DonohueRD/huey-console/hardware/huey_cart_v3/labels/labels_blank.pdf

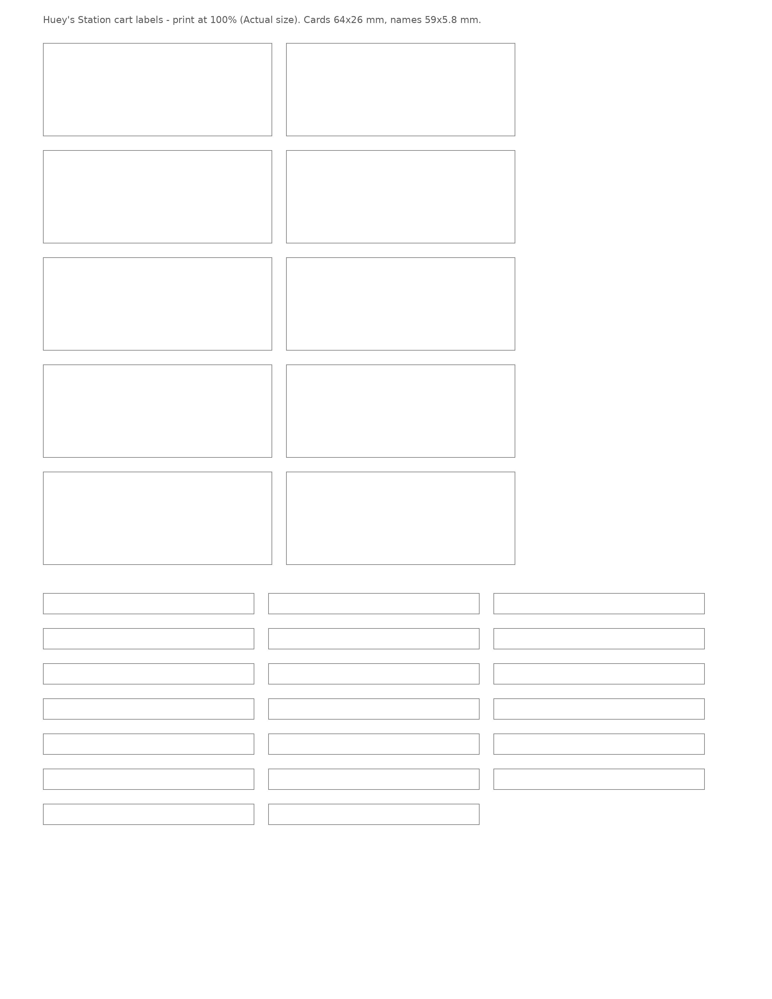
[picture p1: page 1]
