DonohueRD/huey-console/hardware/huey_cart_v3/labels/labels_sample.pdf

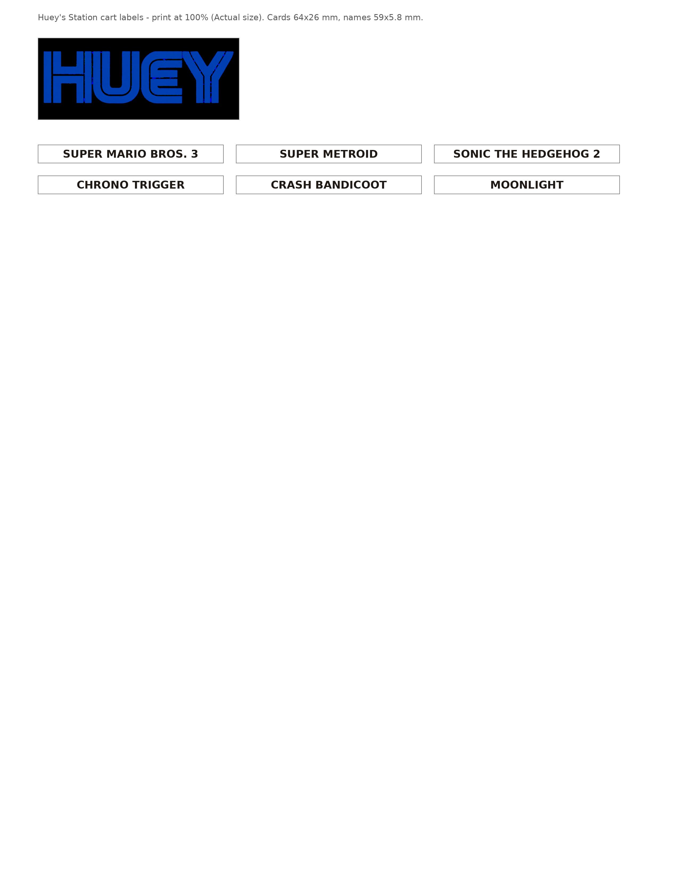
[picture p2: page 1]
