DonohueRD/huey-console/hardware/huey_cart_v3/cart_v3_slidein.png

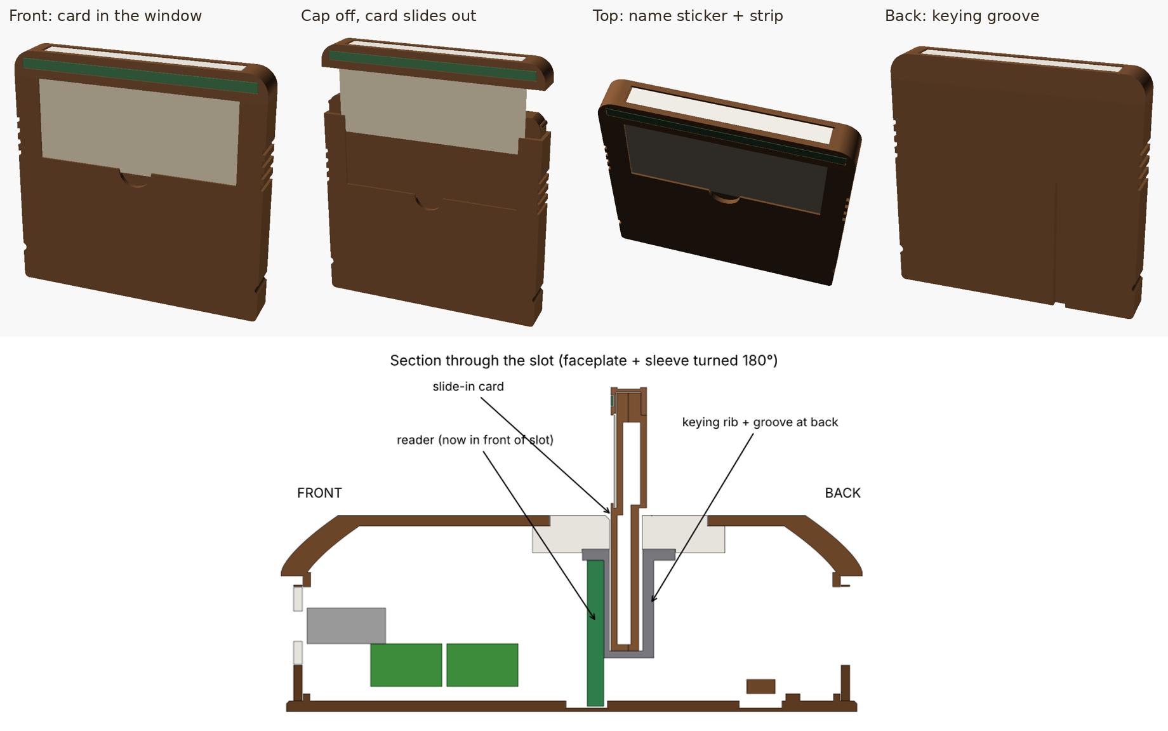
hardware/huey_cart_v3/cart_v3_slidein.png
