DonohueRD/huey-console/hardware/huey_cart_v3/labels/art/Huey's Station.png

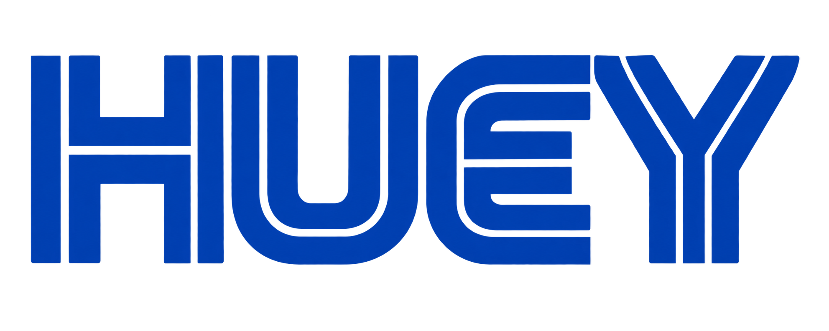
hardware/huey_cart_v3/labels/art/Huey's Station.png
