DonohueRD/huey-console/hardware/huey_station_v1/huey_station_renders.png

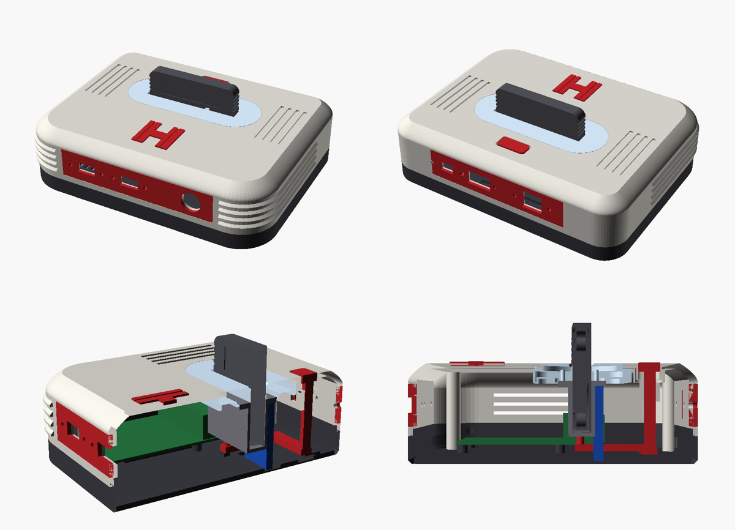
hardware/huey_station_v1/huey_station_renders.png
