DonohueRD/huey-console/hardware/huey_walnut_v1/walnut_edition_renders.png

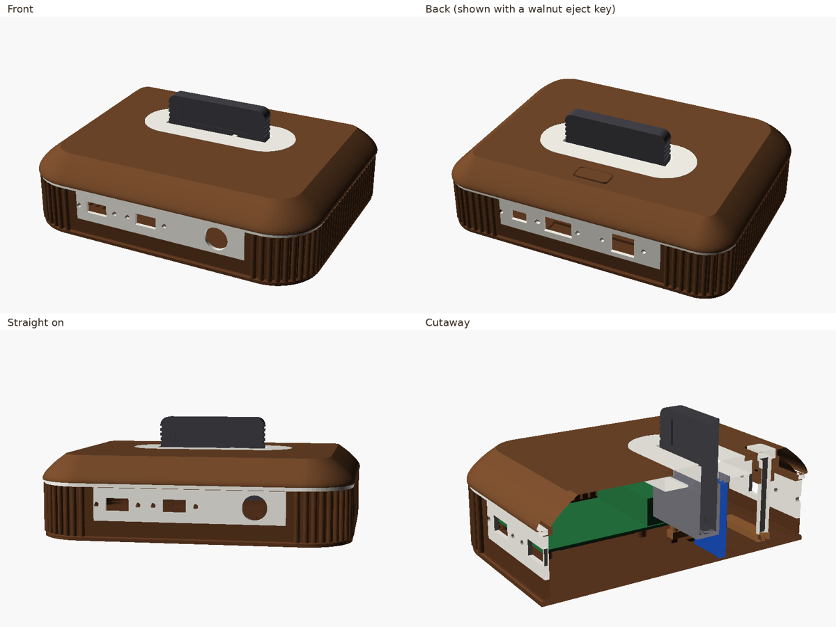
hardware/huey_walnut_v1/walnut_edition_renders.png
