DonohueRD/huey-console/hardware/huey_cart_v3/stl/cart_front.stl

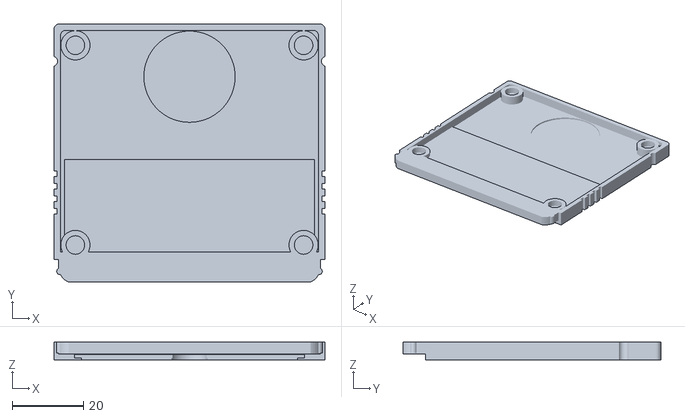
[picture p7: CAD file, 2026-10-06]
hardware/huey_cart_v3/stl/cart_front.stl
76.0 x 72.4 x 5.00
