DonohueRD/huey-console/hardware/huey_station_v1/stl/lever.stl

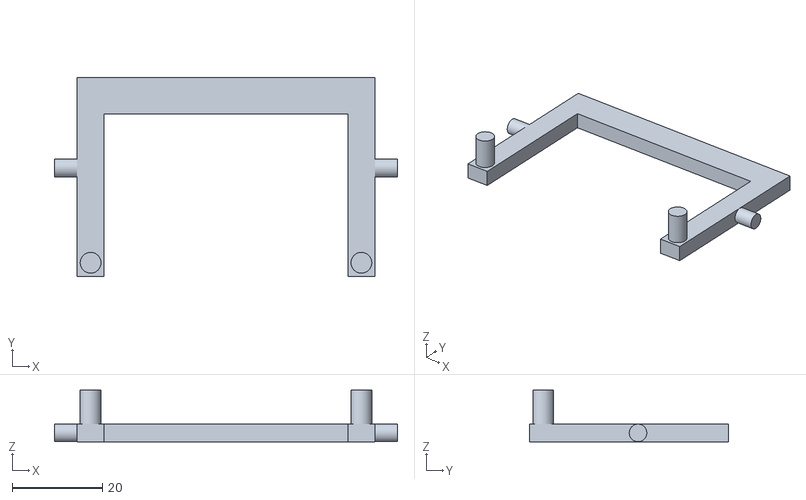
[picture p8: CAD file, 2026-10-06]
hardware/huey_station_v1/stl/lever.stl
76.0 x 44.0 x 11.5
