DonohueRD/huey-console/hardware/huey_cart_v3/stl/front_plate.stl

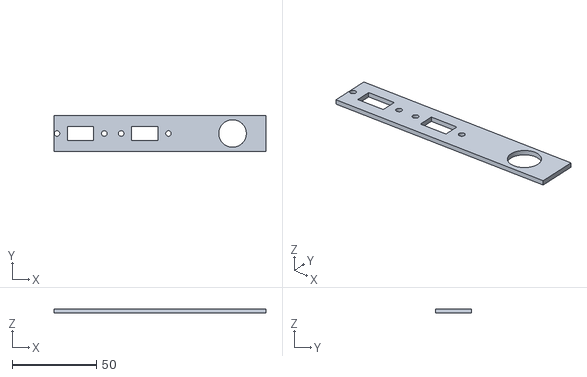
[picture p9: CAD file, 2026-10-06]
hardware/huey_cart_v3/stl/front_plate.stl
125.6 x 21.6 x 2.40
