DonohueRD/huey-console/hardware/huey_station_v1/stl/key.stl

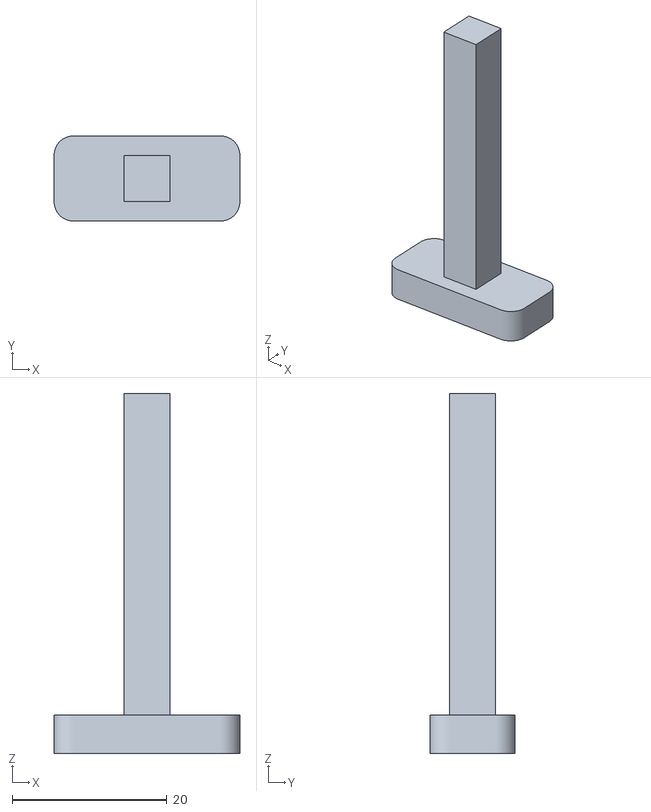
[picture p10: CAD file, 2026-10-06]
hardware/huey_station_v1/stl/key.stl
24.0 x 11.0 x 46.5
