DonohueRD/huey-console/hardware/huey_walnut_v1/stl/faceplate.stl

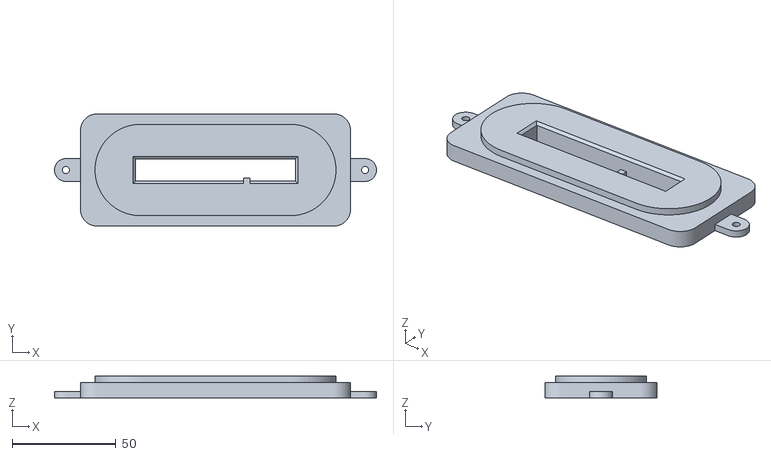
[picture p11: CAD file, 2026-10-06]
hardware/huey_walnut_v1/stl/faceplate.stl
155.0 x 54.0 x 10.5
