DonohueRD/huey-console/hardware/huey_cart_v3/stl/base.stl

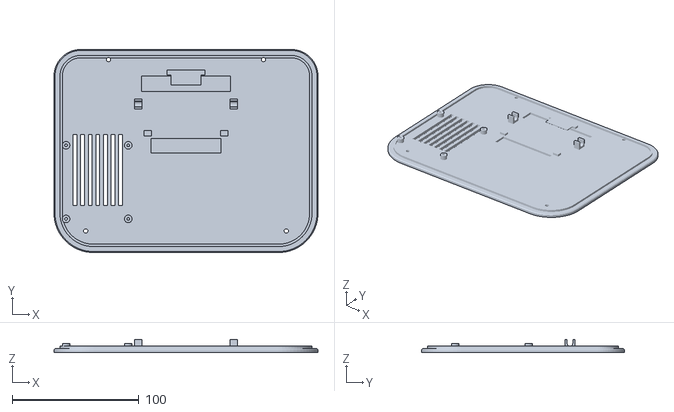
[picture p12: CAD file, 2026-10-06]
hardware/huey_cart_v3/stl/base.stl
208.0 x 160.0 x 10.0
