DonohueRD/huey-console/hardware/huey_station_v1/stl/front_insert.stl

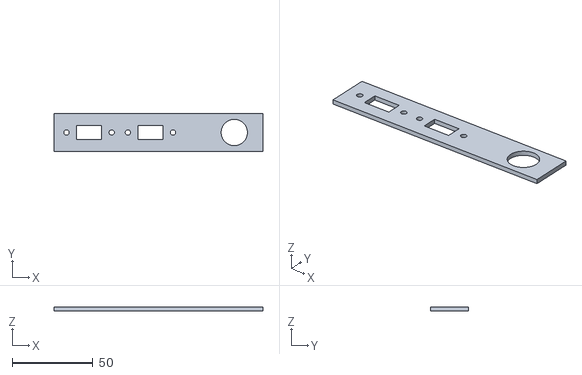
[picture p13: CAD file, 2026-10-06]
hardware/huey_station_v1/stl/front_insert.stl
129.6 x 23.6 x 2.40
