DonohueRD/huey-console/hardware/huey_cart_v3/stl/cart_cap.stl

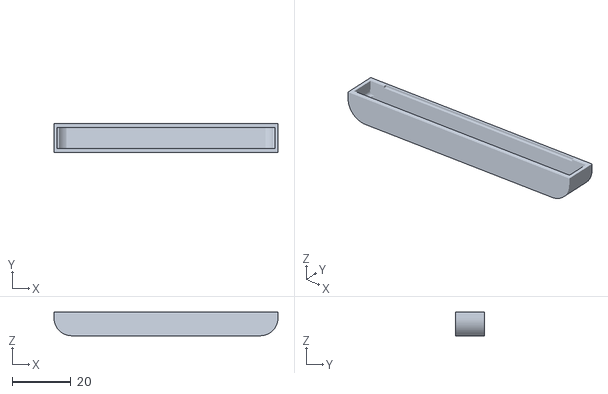
[picture p14: CAD file, 2026-10-06]
hardware/huey_cart_v3/stl/cart_cap.stl
76.0 x 10.0 x 8.00
