DonohueRD/huey-console/hardware/huey_station_v1/stl/cart_back.stl

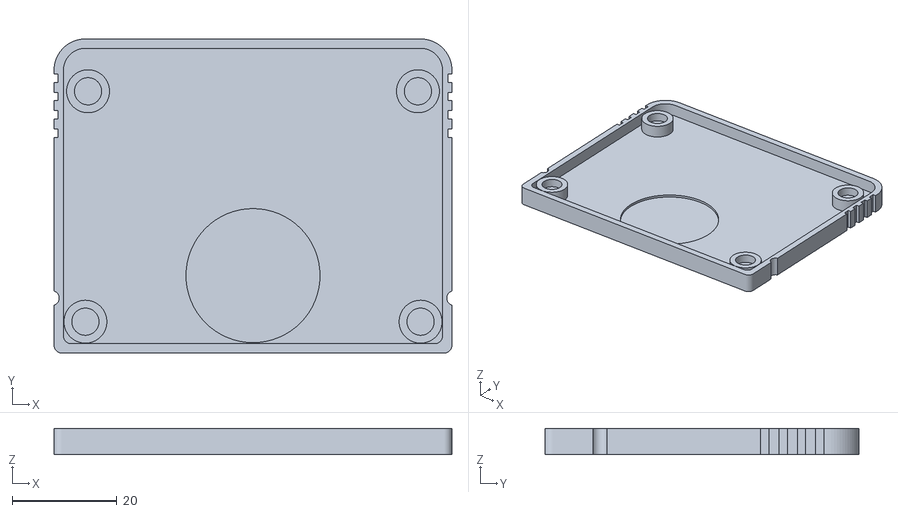
[picture p15: CAD file, 2026-10-06]
hardware/huey_station_v1/stl/cart_back.stl
76.0 x 60.0 x 5.00
