DonohueRD/huey-console/hardware/huey_walnut_v1/stl/body.stl

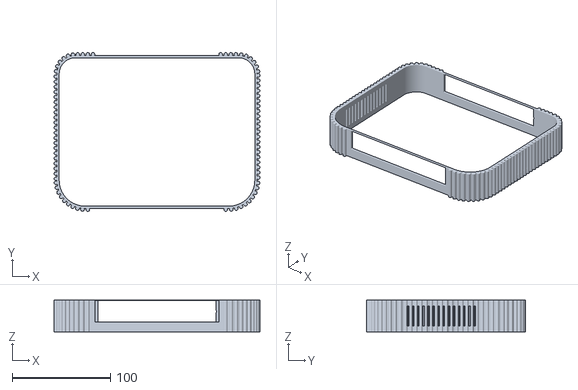
[picture p16: CAD file, 2026-10-06]
hardware/huey_walnut_v1/stl/body.stl
209.8 x 161.8 x 32.5
