DonohueRD/huey-console/hardware/huey_cart_v3/stl/body.stl

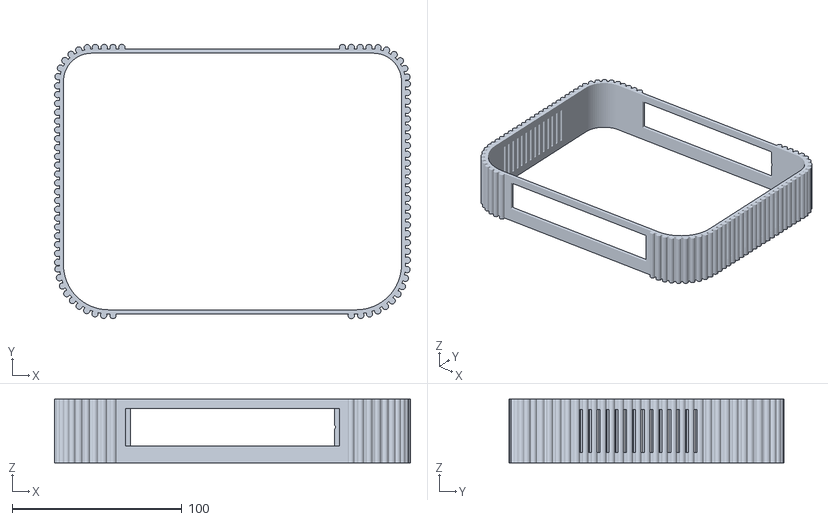
[picture p17: CAD file, 2026-10-06]
hardware/huey_cart_v3/stl/body.stl
209.8 x 161.8 x 37.5
