DonohueRD/huey-console/hardware/huey_walnut_v1/stl/sleeve.stl

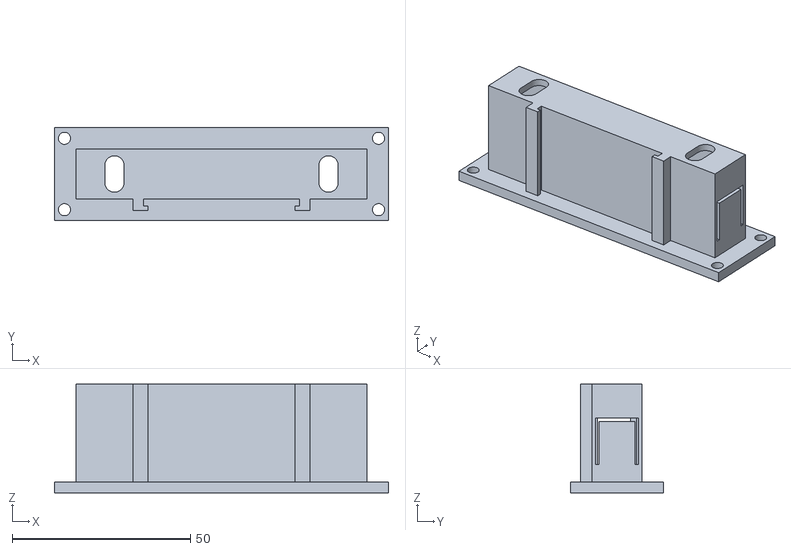
[picture p18: CAD file, 2026-10-06]
hardware/huey_walnut_v1/stl/sleeve.stl
93.6 x 26.0 x 30.5
