DonohueRD/huey-console/hardware/huey_cart_v3/stl/port_test.stl

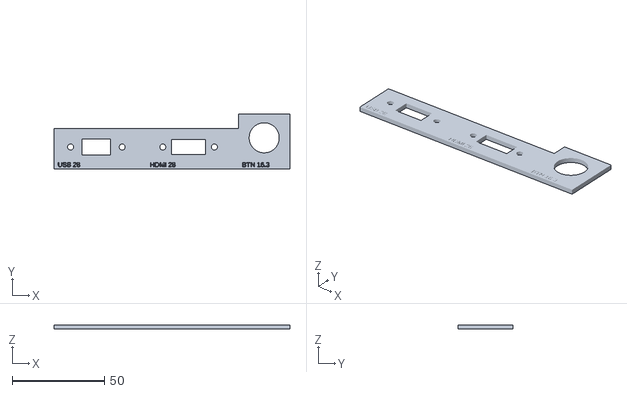
[picture p19: CAD file, 2026-10-06]
hardware/huey_cart_v3/stl/port_test.stl
128.0 x 30.0 x 2.40
