DonohueRD/huey-console/hardware/huey_station_v1/stl/base.stl

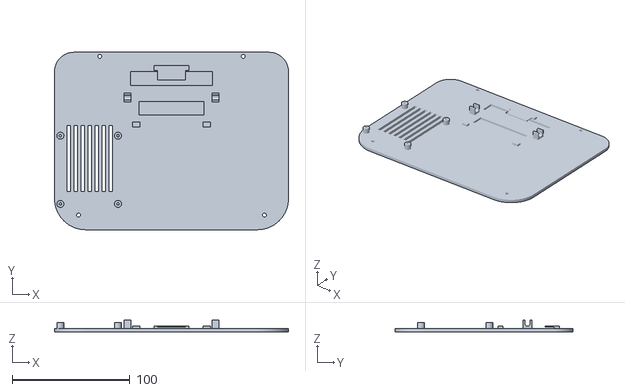
[picture p20: CAD file, 2026-10-06]
hardware/huey_station_v1/stl/base.stl
199.0 x 151.0 x 10.0
