DonohueRD/huey-console/hardware/huey_station_v1/stl/rear_insert.stl

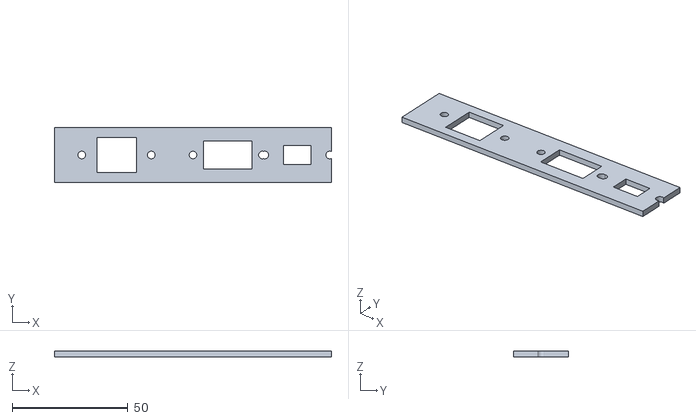
[picture p21: CAD file, 2026-10-06]
hardware/huey_station_v1/stl/rear_insert.stl
119.6 x 23.6 x 2.40
