DonohueRD/huey-console/hardware/huey_cart_v3/stl/cart_strip.stl

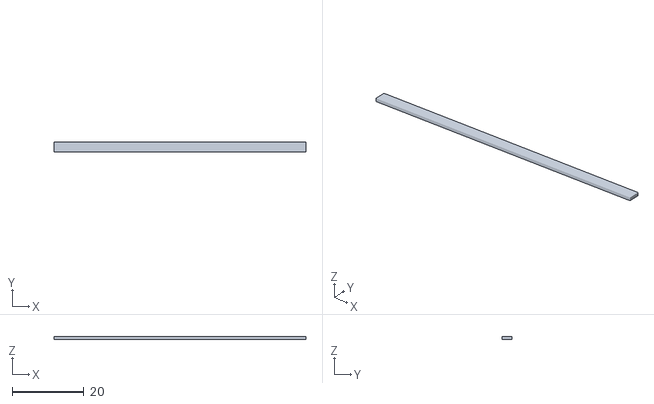
[picture p23: CAD file, 2026-10-06]
hardware/huey_cart_v3/stl/cart_strip.stl
70.0 x 2.80 x 0.8
