DonohueRD/huey-console/hardware/huey_cart_v3/stl/lever.stl

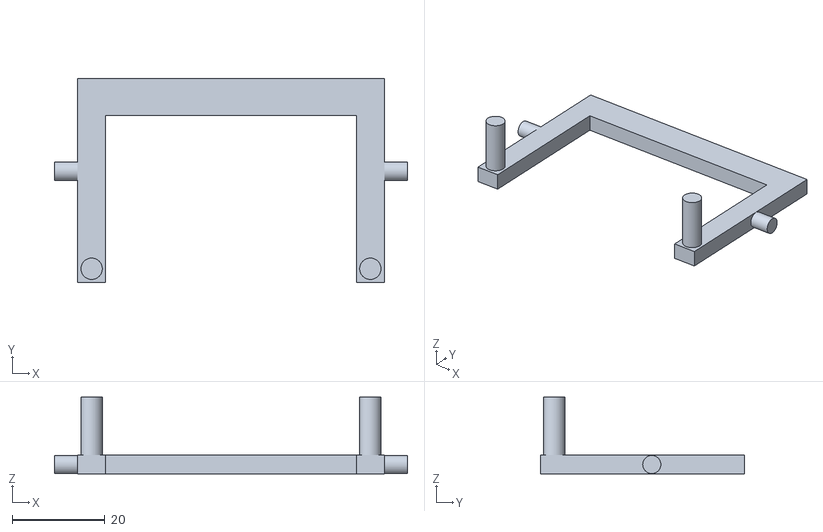
[picture p24: CAD file, 2026-10-06]
hardware/huey_cart_v3/stl/lever.stl
76.0 x 44.0 x 16.5
