DonohueRD/huey-console/hardware/huey_station_v1/stl/badge.stl

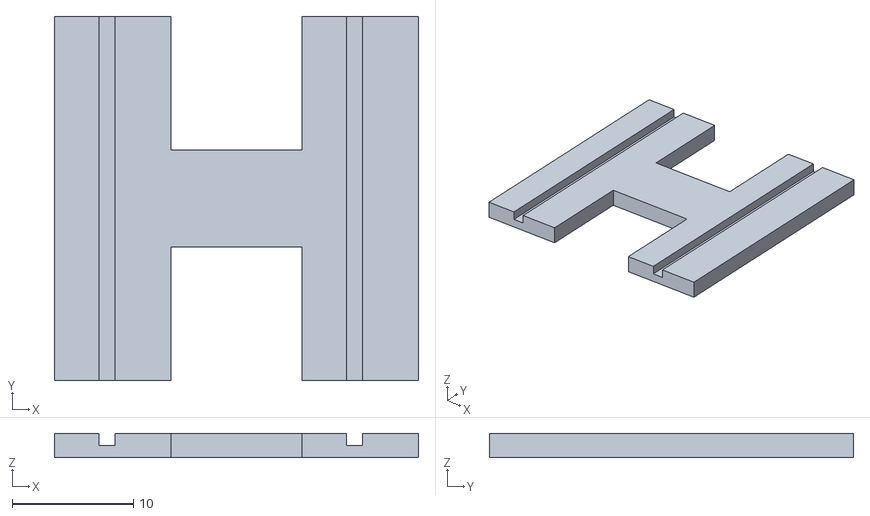
[picture p25: CAD file, 2026-10-06]
hardware/huey_station_v1/stl/badge.stl
30.0 x 30.0 x 2.00
