DonohueRD/huey-console/hardware/huey_walnut_v1/stl/cap.stl

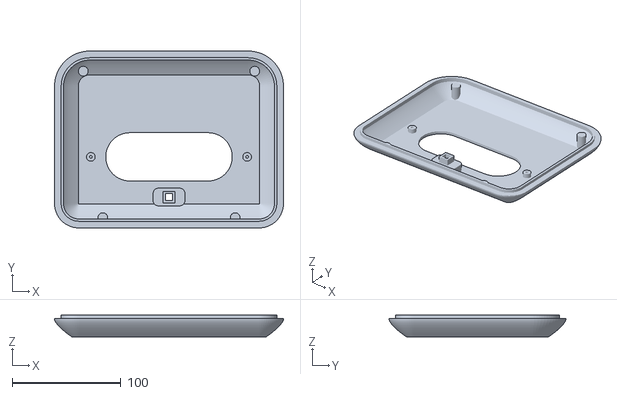
[picture p26: CAD file, 2026-10-06]
hardware/huey_walnut_v1/stl/cap.stl
211.0 x 163.0 x 20.0
