DonohueRD/huey-console/hardware/huey_cart_v3/stl/key.stl

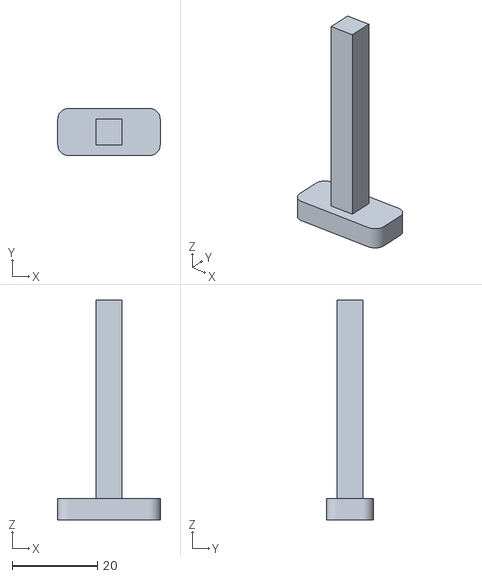
[picture p27: CAD file, 2026-10-06]
hardware/huey_cart_v3/stl/key.stl
24.0 x 11.0 x 51.5
