DonohueRD/huey-console/hardware/huey_station_v1/stl/shell.stl

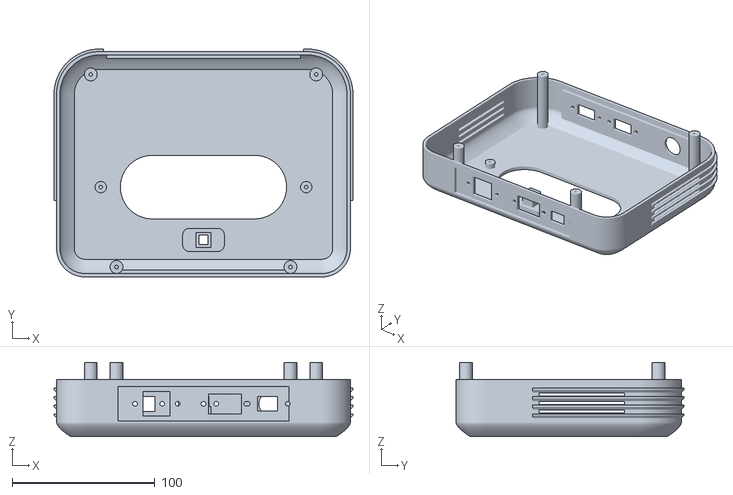
[picture p28: CAD file, 2026-10-06]
hardware/huey_station_v1/stl/shell.stl
209.6 x 159.8 x 52.0
