DonohueRD/huey-console/hardware/huey_walnut_v1/stl/ring.stl

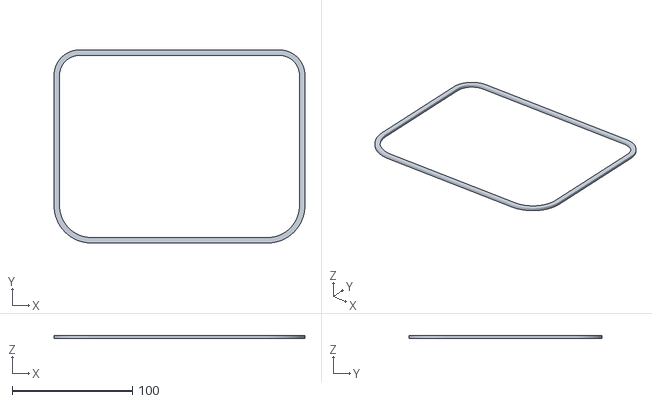
[picture p29: CAD file, 2026-10-06]
hardware/huey_walnut_v1/stl/ring.stl
208.4 x 160.4 x 2.50
