DonohueRD/huey-console/hardware/huey_cart_v3/stl/rear_plate.stl

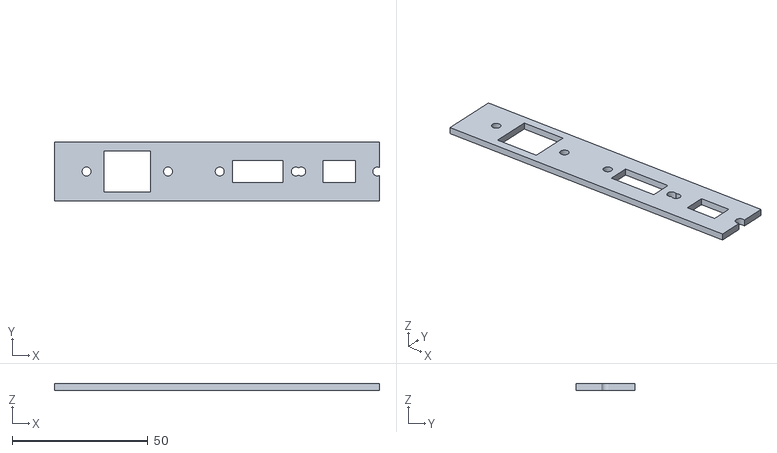
[picture p30: CAD file, 2026-10-06]
hardware/huey_cart_v3/stl/rear_plate.stl
119.6 x 21.6 x 2.40
