DonohueRD/huey-console/hardware/huey_station_v1/stl/bezel.stl

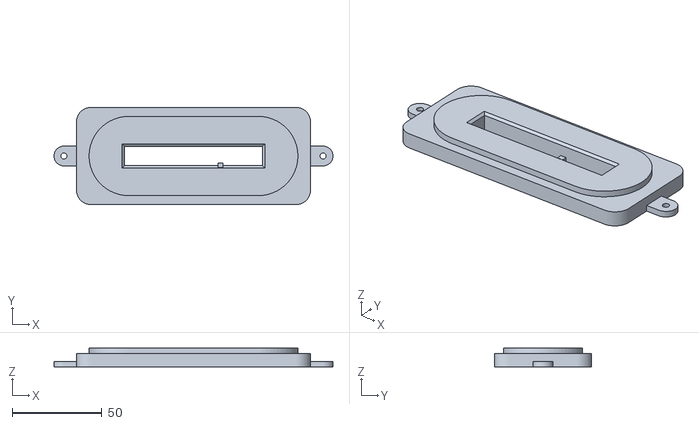
[picture p31: CAD file, 2026-10-06]
hardware/huey_station_v1/stl/bezel.stl
155.0 x 54.0 x 10.5
