DonohueRD/huey-console/hardware/huey_station_v1/stl/band.stl

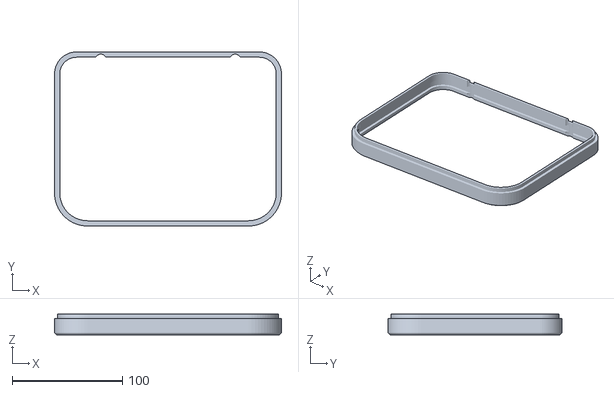
[picture p32: CAD file, 2026-10-06]
hardware/huey_station_v1/stl/band.stl
206.0 x 158.0 x 19.0
