DonohueRD/huey-console/hardware/huey_cart_v3/huey_walnut.scad

// =====================================================================
//  HUEY'S STATION — WALNUT EDITION
//  Reeded walnut body, crowned walnut top, thin marble line around the top,
//  inlaid marble front + rear plates, solid marble slot faceplate,
//  SNES-style eject key (print in wood or marble).
//
//  Uses the existing carts and reader. The sleeve is reprinted (v2) only
//  to add the eject plunger holes; the cart cavity, keying rib and click
//  detent are identical to the original.
//
//  Set `part`, F6, export STL. Parts are oriented for printing.
//  Bambu P1S, all dimensions in mm.
// =====================================================================

/* [Part] */
// assembly | cap | body | ring | base | faceplate | sleeve | lever | key | front_plate | rear_plate
// cart_front | cart_back | cart_cap | cart_strip | label_card | port_test
part = "assembly";
eject_pressed = false;   // assembly preview: show the eject travel
slot_flip = true;        // faceplate + sleeve installed turned 180°: keying rib at the BACK, reader at the front
explode_cap = 0;         // assembly preview: lift the cart cap

/* [Body] */
W = 206;  D = 158;  H = 60;   // 2026-10-05: was 55; +5 mm so the reader PCB clears the base (only body, lever, key change)
front_r = 30;  back_r = 20;   // same footprint as the v1 detailed model
crown = 16;  crown_p = 1.45;  // crowned top: 16 mm rise, max ~55° so it prints upside down
wall = 2.4;  top_t = 3;  base_t = 3;
core = 1.0;                   // body core sits 1 mm inside the footprint; reeds stand proud
reed_r = 1.9;  reed_pitch = 5.2;
ring_t = 2.5;                 // thin marble line between body and top
zr = H - crown - 1 - ring_t;  // top of the reeded body (35.5)
zc = zr + ring_t;             // bottom of the walnut top (38)
cap_over = 2.5;               // top overhangs the reeds slightly, like the stand's top lip
lip = 3;                      // top's lip that drops inside the body
inner_in = core + wall;       // inner wall inset (3.4)

/* [Slot / bezel] */
slot_x = W/2;  slot_y = 95;
pill = [116, 44];       // visible clear bezel
flange = [130, 54];     // bezel flange under the top skin
bezel_t = 10.5;         // same stack height as the original disc
ear_x = 72;             // bezel screw ears (each side)
led_in  = [98, 30];     // LED channel inner edge (clears the sleeve flange)
led_out = [124, 50];    // LED channel outer edge (10 mm strip)
led_d   = 3;

/* [Eject] */
eject_y  = 132;         // key position (behind the slot)
pivot_y  = 116;          // closer to the key = more lift at the cart
plunger_x = 30;         // plungers at ±30 mm under the cart
arm_w = 6;  arm_t = 4;  arm_z = 5;      // lever arms: z 5..9 at rest
key_cap = [24, 11];  key_stem = 6;  key_travel = 3.5;   // cart lifts ~4.6 mm

/* [Raspberry Pi 3: long axis front-to-back, USB end at the back] */
pi_x0 = 5;  pi_y0 = 22;  standoff = 4;

/* [Front panel parts — measure yours and adjust] */
// 2026-10-04 measured: USB-A flange ~39.5 x 11.4, nose ~15 x 7. port_test printed: USB + HDMI cutouts and screw spacing fit
usb_face  = [15.5, 8.5];  usb_body = [18, 10.5];  usb_screw = 28;   // USB-A panel mount
usb_x = [56, 94];       // centres
// 2026-10-04 measured: 16 mm thread, head ~19.5, depth incl. pins ~24.5
btn_d = 16.3;  btn_x = 146;
/* [Rear panel parts — measure yours and adjust] */
// RJ45 and power panel mounts not bought yet: standard dimensions
rj_face = [17, 15];   rj_screw = 30;  rj_x = 70;     // RJ45 panel mount
// 2026-10-04 measured: flange 38.4 x 11.1, nose 17.7 x 7.1, holes 31 outside-to-outside (M3 brass) = 28 centres
hdmi_face = [18.6, 8]; hdmi_screw = 28; hdmi_x = 118; // HDMI panel mount
pwr_face = [12, 8];   pwr_screw = 28; pwr_x = 148;   // micro-USB / USB-C panel mount
screw_d = 3.3;

/* [Cart, reader, sleeve — unchanged from the original design] */
cart_w = 76;  cart_t = 10;  cart_h = 74;  insert_depth = 38;   // v3 cart: 36 mm stands above the slot
cart_wall = 1.8;  clear = 0.4;  key_x = 15;  rib_w = 3;  rib_d = 1.6;
tongue_len = 12;  tongue_w = 10;  tongue_top = 8;  bump = 0.8;  bump_r = 1.2;
pcb_w = 43;  pcb_h = 41;  pcb_t = 1.6;  rail_lip = 1.2;
tag_d = 25;  mag_d = 5.2;  mag_h = 2.2;
/* [Cart v3: slide-in card + clip cap] */
cap_h = 8;  ten = 1.6;  ten_end = 1.2;  cap_fit = 0.15;   // cap slips over a tenon
card = [64, 26];  card_t = 0.9;                // card channel (cardstock / photo paper, ~0.3 mm)
win_x = 60.6;  lip_t = 0.6;  card_z0 = insert_depth + 2;  // window: lips 1.7 mm each side
strip = [cart_w - 6, 2.8, 0.8];                // system-color strip on the cap front
name_rec = [60, 6.4, 0.6];                     // name sticker recess on the cap top

$fn = 64;  eps = 0.01;

// ------------------------------------------------------------- derived --
ow = cart_w + 2*clear;  ot = cart_t + 2*clear;
end_w = 2.4;  side_w = 1.6;
sf_pad = 6;  sf_t = 3;  sf_pocket = 1;
sleeve_in = insert_depth - (bezel_t - sf_pocket);     // 28.5
sleeve_floor = 2;
sx = ow/2 + end_w;  sy = ot/2 + side_w;
sf_x = sx + sf_pad;  sf_y = sy + sf_pad;
sf_holes = [[ sf_x-2.8,  sy+3], [-(sf_x-2.8),  sy+3],
            [ sf_x-2.8, -(sy+3)], [-(sf_x-2.8), -(sy+3)]];
bezel_z0 = H - bezel_t;                       // bezel underside (world)
sleeve_top = bezel_z0 + sf_pocket;            // sleeve flange top (world)
cart_bottom = H - insert_depth;               // 17
floor_bot = cart_bottom - sleeve_floor;       // 15
reader_mid = sleeve_top - sf_t - pcb_h/2;
tag_z = max(reader_mid - cart_bottom, cart_wall + tag_d/2 + 0.5);
det_from_top = tongue_top + tongue_len - 2;
det_z = insert_depth - (bezel_t - sf_pocket) - det_from_top;
pivot_z = arm_z + arm_t/2;
lift_ratio = (pivot_y - slot_y) / (eject_y - pivot_y);
base_bosses = [[24, 16], [W-24, 16], [42, 151], [W-42, 151]];
fp = [W/2 - 63, 13, 126, 22];   // inlaid marble front plate x, z, w, h
rp = [W/2 - 60, 13, 120, 22];   // inlaid marble rear plate

// ================================================================ body ==
module foot2d(g = 0) offset(delta = g) hull() {
    for (x = [front_r, W - front_r]) translate([x, front_r]) circle(front_r);
    for (x = [back_r, W - back_r]) translate([x, D - back_r]) circle(back_r);
}
module zslab(z0, z1) translate([-50, -50, z0]) cube([W + 100, D + 100, z1 - z0]);
function crown_pts(off, ztop) = [for (i = [0:14]) let(d = crown*i/14) [crown*pow(1 - d/crown, crown_p) - off, ztop - d]];
module slices(pts) hull() for (q = pts) translate([0, 0, q[1]]) linear_extrude(eps) foot2d(-q[0]);
module cap_outer() slices(concat([[-cap_over, zc]], crown_pts(cap_over, H)));
module cap_inner() slices(concat([[inner_in, zc - 1]], crown_pts(-inner_in, H - top_t)));
module pill2d(sz, grow = 0) offset(r = sz[1]/2 + grow) square([sz[0] - sz[1], eps], center = true);
module rrect2d(sz, r) offset(r = r) square([sz[0] - 2*r, sz[1] - 2*r], center = true);
function pi_holes() = [for (hx = [3.5, 52.5], hy = [3.5, 61.5]) [pi_x0 + hx, pi_y0 + hy]];

// reed centres around the footprint, tagged by face
function arc(cx, cy, r, a0, step) = let(da = step / r * 180 / PI)
    [for (a = [a0 + da/2 : da : a0 + 90 - da/4]) [cx + r*cos(a), cy + r*sin(a), "c"]];
function reeds_pts() = let(s = reed_pitch, fr = front_r, br = back_r) concat(
    [for (x = [fr + s/2 : s : W - fr]) [x, 0, "front"]], arc(W - fr, fr, fr, -90, s),
    [for (y = [fr + s/2 : s : D - br]) [W, y, "right"]],  arc(W - br, D - br, br, 0, s),
    [for (x = [W - br - s/2 : -s : br]) [x, D, "back"]],  arc(br, D - br, br, 90, s),
    [for (y = [D - br - s/2 : -s : fr]) [0, y, "left"]],  arc(fr, fr, fr, 180, s));
function reed_ok(p) = !(p[2] == "front" && abs(p[0] - (fp[0] + fp[2]/2)) < fp[2]/2 + 3)
                   && !(p[2] == "back"  && abs(p[0] - (rp[0] + rp[2]/2)) < rp[2]/2 + 3);
// vent slots hide in the valleys between reeds on the left (over the Pi) and right
function vent_ys() = [for (y = [front_r + reed_pitch : reed_pitch : D - back_r]) if (y > 40 && y < 112) y];

// ========================================================== walnut top ===
// Crowned top, z = zc..H. Prints upside down on its flat plateau.
module cap() {
    difference() {
        union() {
            difference() { cap_outer(); cap_inner(); }
            // lip that drops inside the marble ring and the body
            translate([0, 0, zc - lip]) linear_extrude(lip + 1)
                difference() { foot2d(-inner_in - 0.25); foot2d(-inner_in - 2.4); }
            intersection() {
                cap_outer();
                union() {
                    for (p = base_bosses) translate([p[0], p[1], base_t]) cylinder(d = 9, h = H);
                    for (m = [-1, 1]) translate([slot_x + m*ear_x, slot_y, bezel_z0 + 3]) cylinder(d = 8, h = 10);
                    translate([slot_x, eject_y, H - 9 - 1.6]) linear_extrude(9 + 1.6)
                        rrect2d([key_cap[0] + 2 + 3.2, key_cap[1] + 2 + 3.2], 4.6);
                    translate([slot_x, eject_y, H - 21]) linear_extrude(12) square(key_stem + 4.6, center = true);
                }
            }
        }
        for (p = base_bosses) translate([p[0], p[1], -1]) cylinder(d = 2.6, h = base_t + 14);
        for (m = [-1, 1]) translate([slot_x + m*ear_x, slot_y, bezel_z0]) cylinder(d = 2.6, h = 9);
        translate([slot_x, slot_y, H - top_t - 1]) linear_extrude(top_t + 2) pill2d(pill, 0.25);
        translate([slot_x, eject_y, H - 9]) linear_extrude(10) rrect2d([key_cap[0] + 2, key_cap[1] + 2], 3);
        translate([slot_x, eject_y, H - 30]) linear_extrude(30) square(key_stem + 0.6, center = true);
    }
}

// ========================================================== marble ring ===
module ring() translate([0, 0, zr]) linear_extrude(ring_t)
    difference() { foot2d(1.2); foot2d(-inner_in); }

// ======================================================= reeded body ===
// Walnut walls z = base_t..zr. Prints right side up (an open tube, no overhangs).
module body() {
    difference() {
        union() {
            translate([0, 0, base_t]) linear_extrude(zr - base_t) foot2d(-core);
            for (p = reeds_pts()) if (reed_ok(p)) translate([p[0], p[1], base_t]) cylinder(r = reed_r, h = zr - base_t, $fn = 16);
            // backing pads behind the inlaid plates
            intersection() {
                translate([0, 0, base_t]) linear_extrude(zr) foot2d(-core);
                union() {
                    translate([fp[0] - 3, inner_in - eps, fp[1] - 3]) cube([fp[2] + 6, 2.4, zr - lip - 0.5 - fp[1] + 3]);
                    translate([rp[0] - 3, D - inner_in - 2.4 + eps, rp[1] - 3]) cube([rp[2] + 6, 2.4, zr - lip - 0.5 - rp[1] + 3]);
                }
            }
        }
        translate([0, 0, base_t - 1]) linear_extrude(zr + 2) foot2d(-inner_in);
        // inlay recesses (flush marble plates) + openings
        translate([fp[0], -5, fp[1]]) cube([fp[2], core + 2.4 + 5, fp[3]]);
        translate([rp[0], D - core - 2.4, rp[1]]) cube([rp[2], 10, rp[3]]);
        front_openings(true);
        rear_openings(true);
        // vents in the reed valleys
        for (y = vent_ys()) for (x = [-1, W - inner_in - 1])
            translate([x, y - 0.9, base_t + 6]) cube([inner_in + 2, 1.8, zr - base_t - 12]);
    }
}

module front_openings(through) {
    yy = through ? -1 : -0.5;
    len = through ? core + 2.4 + 2.4 + 2 : 4;
    cz = fp[1] + fp[3]/2;
    for (x = usb_x) {
        translate([x - (through ? usb_body[0] : usb_face[0])/2, yy, cz - (through ? usb_body[1] : usb_face[1])/2])
            cube([through ? usb_body[0] : usb_face[0], len, through ? usb_body[1] : usb_face[1]]);
        for (m = [-1, 1]) translate([x + m*usb_screw/2, yy, cz]) rotate([-90, 0, 0]) cylinder(d = screw_d, h = len);
    }
    translate([btn_x, yy, cz]) rotate([-90, 0, 0]) cylinder(d = btn_d, h = len);
}
module rear_openings(through) {
    len = through ? core + 2.4 + 2.4 + 2 : 4;
    y0 = through ? D - len + 1 : D - core - 3.5;
    cz = rp[1] + rp[3]/2;
    for (c = [[rj_x, rj_face, rj_screw], [hdmi_x, hdmi_face, hdmi_screw], [pwr_x, pwr_face, pwr_screw]]) {
        translate([c[0] - c[1][0]/2 - (through ? 1 : 0), y0, cz - c[1][1]/2 - (through ? 1 : 0)])
            cube([c[1][0] + (through ? 2 : 0), len, c[1][1] + (through ? 2 : 0)]);
        for (m = [-1, 1]) translate([c[0] + m*c[2]/2, y0, cz]) rotate([-90, 0, 0]) cylinder(d = screw_d, h = len);
    }
}

// ============================================== base (walnut bottom lip) ==
// The body sits on top of it; 4 screws pull the base up into the top,
// clamping body and marble ring in between.
module base() difference() {
    union() {
        hull() {
            linear_extrude(base_t - 0.8) foot2d(1.0);
            linear_extrude(base_t) foot2d(0.2);
        }
        // locating ridge just inside the body wall
        translate([0, 0, base_t - eps]) linear_extrude(2) difference() { foot2d(-inner_in - 0.3); foot2d(-inner_in - 2.2); }
        for (p = pi_holes()) translate([p[0], p[1], 0]) cylinder(d = 6, h = base_t + standoff);
        for (m = [-1, 1]) translate([slot_x + m*(plunger_x + arm_w/2 + 4.5) - 3, pivot_y - 4, 0])
            difference() {
                cube([6, 8, pivot_z + 3]);
                translate([-1, 4, pivot_z]) rotate([0, 90, 0]) cylinder(d = 4.4, h = 8);
                translate([-1, 4 - 2.2, pivot_z]) cube([8, 4.4, 10]);
            }
        for (m = [-1, 1]) translate([slot_x + m*plunger_x - 3, slot_y - 4, 0]) cube([6, 4, arm_z]);
        translate([slot_x - 15, eject_y + 7, 0]) cube([30, 4, base_t + 2]);
        translate([slot_x - 12, 0, 0]) hull() {
            translate([0, eject_y + 7, base_t + 0.8]) cube([24, 1, 1.2]);
            translate([0, eject_y - 1, arm_z - 1.2]) cube([24, 1, 1.2]);
        }
    }
    for (p = pi_holes()) translate([p[0], p[1], 1]) cylinder(d = 2.2, h = base_t + standoff);
    for (p = base_bosses) translate([p[0], p[1], 0]) {
        translate([0, 0, -1]) cylinder(d = 3.4, h = base_t + 4);
        translate([0, 0, -eps]) cylinder(d1 = 6.6, d2 = 3.4, h = 1.6);
    }
    translate([slot_x - plunger_x - arm_w/2 - 2, eject_y - 6, 1]) cube([2*plunger_x + arm_w + 4, 12, base_t]);
    translate([slot_x - pcb_w/2 - 6, slot_flip ? slot_y - sy + 1 - (pcb_t + 10) : slot_y + sy - 1, 1]) cube([pcb_w + 12, pcb_t + 10, base_t]);   // reader clearance
    for (i = [0:6]) translate([pi_x0 + 9 + i*6, pi_y0 + 14, -1]) cube([3, 56, base_t + 2]);
    for (p = [[30, 22], [W - 30, 22], [26, D - 22], [W - 26, D - 22]]) translate([p[0], p[1], -eps]) cylinder(d = 10.5, h = 1);
}

// ================================================ marble slot faceplate ===
// Solid marble, flange side down. Same stack height as the original disc,
// so the sleeve, carts and click are unchanged.
module bezel() difference() {
    union() {
        linear_extrude(bezel_t - top_t) rrect2d(flange, 8);
        linear_extrude(bezel_t) pill2d(pill);
        for (m = [-1, 1]) translate([m*ear_x, 0, 0]) linear_extrude(3)
            hull() { circle(d = 11); translate([-m*8, 0]) square([1, 11], center = true); }
    }
    // cart opening with entry chamfer, keeping the keying rib
    difference() {
        union() {
            translate([-ow/2, -ot/2, -1]) cube([ow, ot, bezel_t + 2]);
            hull() {
                translate([-ow/2, -ot/2, bezel_t - 1.2]) cube([ow, ot, eps]);
                translate([-ow/2 - 1.2, -ot/2 - 1.2, bezel_t]) cube([ow + 2.4, ot + 2.4, eps]);
            }
        }
        rib();
    }
    // sleeve flange pocket + pilots
    translate([-sf_x - 0.2, -sf_y - 0.2, -eps]) cube([2*sf_x + 0.4, 2*sf_y + 0.4, sf_pocket]);
    for (p = sf_holes) translate([p[0], p[1], -1]) cylinder(d = 2.6, h = 9);
    // ear screw holes
    for (m = [-1, 1]) translate([m*ear_x, 0, -1]) cylinder(d = 3.4, h = 5);
}

module rib(len = 200) translate([key_x - rib_w/2, -ot/2 - 1, -len/2]) cube([rib_w, rib_d + 1, len]);

// ========================================================== sleeve v2 ===
// Original sleeve + two plunger holes in the floor for the eject lever.
module sleeve() {
    total = sleeve_in + sleeve_floor;
    difference() {
        union() {
            translate([-sf_x, -sf_y, -sf_t]) cube([2*sf_x, 2*sf_y, sf_t]);
            translate([-sx, -sy, -total]) cube([2*sx, 2*sy, total]);
            for (m = [0, 1]) mirror([m, 0, 0])
                translate([pcb_w/2 + 0.3 - rail_lip, sy, -total]) difference() {
                    cube([rail_lip + 3, pcb_t + 0.4 + 1.2, total]);
                    translate([-eps, -eps, -1]) cube([rail_lip + eps, pcb_t + 0.4 + eps, total + 2]);
                }
        }
        difference() { translate([-ow/2, -ot/2, -sleeve_in]) cube([ow, ot, sleeve_in + 10]); rib(); }
        for (m = [0, 1]) mirror([m, 0, 0]) tongue_cut();
        for (p = sf_holes) translate([p[0], p[1], -sf_t - 1]) cylinder(d = 3.4, h = sf_t + 2);
        // plunger slots (the plungers swing slightly as the lever tips)
        for (m = [-1, 1]) translate([m*plunger_x, 0, -total - 3]) linear_extrude(10)
            hull() for (yy = [-2.4, 2.4]) translate([0, yy]) circle(d = 5.4);
    }
    for (m = [0, 1]) mirror([m, 0, 0]) translate([ow/2 + eps, 0, -det_from_top]) intersection() {
        rotate([90, 0, 0]) cylinder(r = bump_r, h = tongue_w - 1, center = true);
        translate([-bump, -tongue_w, -3]) cube([bump, 2*tongue_w, 6]);
    }
}
module tongue_cut() {
    gap = 1;  z_top = -tongue_top;
    translate([ow/2 - 1, 0, 0]) difference() {
        translate([0, -tongue_w/2 - gap, z_top - tongue_len - gap]) cube([end_w + 2, tongue_w + 2*gap, tongue_len + gap]);
        translate([-1, -tongue_w/2, z_top - tongue_len]) cube([end_w + 4, tongue_w, tongue_len + 1]);
    }
}

// ======================================================= eject lever ===
// U-shaped seesaw. Key presses the back bar down; the front of each arm
// rises and pushes a plunger up through the sleeve floor, popping the cart.
// Modeled in world coordinates at rest.
module lever() {
    tip = cart_bottom - 0.5;          // plunger tip sits just below the floor at rest
    for (m = [-1, 1]) {
        translate([slot_x + m*plunger_x - arm_w/2, slot_y - 3, arm_z]) cube([arm_w, eject_y + 4 - slot_y + 3, arm_t]);
        translate([slot_x + m*plunger_x, slot_y, arm_z + arm_t - eps]) cylinder(d = 4.6, h = tip - arm_z - arm_t);
        // pivot stubs
        translate([slot_x + m*(plunger_x + arm_w/2) - (m < 0 ? 5 : 0), pivot_y, pivot_z])
            rotate([0, 90, 0]) cylinder(d = 3.9, h = 5);
    }
    translate([slot_x - plunger_x - arm_w/2, eject_y - 4, arm_z]) cube([2*plunger_x + arm_w, 8, arm_t]);
}

// ========================================================== eject key ===
module eject_key() {
    stem_len = (H - 4.5) - (arm_z + arm_t);
    translate([0, 0, stem_len]) linear_extrude(5) rrect2d(key_cap, 2.5);
    translate([-key_stem/2, -key_stem/2, 0]) cube([key_stem, key_stem, stem_len + eps]);
}

// ===================================================== color inserts ===
module front_insert() difference() {      // flush with the walnut core
    translate([fp[0] + 0.2, core, fp[1] + 0.2]) cube([fp[2] - 0.4, 2.4, fp[3] - 0.4]);
    front_openings(false);
}
module rear_insert() difference() {
    translate([rp[0] + 0.2, D - core - 2.4, rp[1] + 0.2]) cube([rp[2] - 0.4, 2.4, rp[3] - 0.4]);
    rear_openings(false);
}

// Fit-test strip: same 2.4 mm thickness, openings and screw holes as the marble plates.
// Screw the real panel mounts / button onto it before printing the plates. ~10 min.
module port_test() {
    difference() {
        linear_extrude(2.4) union() {
            square([128, 22]);                      // USB | HDMI | button, one strip
            translate([100, 0]) square([28, 30]);   // taller button tile
        }
        // labels engraved 0.6 deep from the top; openings cut through
        translate([0, 0, 1.8]) linear_extrude(1) {
            translate([2, 1.2]) text(str("USB ", usb_screw), size = 2.6);
            translate([52, 1.2]) text(str("HDMI ", hdmi_screw), size = 2.6);
            translate([102, 1.2]) text(str("BTN ", btn_d), size = 2.6);
        }
        translate([0, 0, -1]) linear_extrude(4.4) {
            translate([23, 12]) { square(usb_face, center = true);
                for (m = [-1, 1]) translate([m*usb_screw/2, 0]) circle(d = screw_d, $fn = 32); }
            translate([73, 12]) { square(hdmi_face, center = true);
                for (m = [-1, 1]) translate([m*hdmi_screw/2, 0]) circle(d = screw_d, $fn = 32); }
            translate([114, 17]) circle(d = btn_d, $fn = 96);
        }
    }
}

// =========================================================== cartridge ==
module cart_profile(inset = 0) {
    r_top = 6 - inset;  r_bot = 1.5;  w = cart_w - 2*inset;  h = cart_h - 2*inset;
    translate([-w/2, inset]) hull() {
        translate([r_bot, r_bot]) circle(r_bot);  translate([w - r_bot, r_bot]) circle(r_bot);
        translate([r_top, h - r_top]) circle(r_top);  translate([w - r_top, h - r_top]) circle(r_top);
    }
}
module cart_solid(inset = 0, t = cart_t) rotate([90, 0, 0]) linear_extrude(t, center = true) cart_profile(inset);
// ====================================================== cart v3 ========
// Two halves held by 4 magnets, NFC tag inside. Front: slide-in card window.
// Top: tenon for the clip cap. Keying groove on the BACK (slot_flip).
// Seen from the front, the groove sits at x = -key_x (the rib turned 180°).
key_gx = slot_flip ? -key_x : key_x;
body_top = cart_h - cap_h;                      // 66: where the cap starts
mag_posts = [[cart_w/2 - 6, 6], [-(cart_w/2 - 6), 6], [cart_w/2 - 6, body_top - 4], [-(cart_w/2 - 6), body_top - 4]];
module tenon_profile(fit = 0) offset(delta = fit) intersection() {
    translate([-cart_w/2 + ten_end, 0]) square([cart_w - 2*ten_end, cart_h]);
    offset(delta = -ten_end) cart_profile();
}
module tenon_solid(fit = 0) rotate([90, 0, 0]) linear_extrude(cart_t - 2*ten + 2*fit, center = true) tenon_profile(fit);
module cart_half(front = true) {
    s = front ? -1 : 1;
    groove_here = slot_flip ? !front : front;
    tag_here = slot_flip ? front : !front;
    difference() {
        intersection() {
            union() {
                intersection() {
                    union() {
                        difference() { cart_solid(); cart_solid(cart_wall, cart_t - 2*cart_wall); }
                        for (p = mag_posts) translate([p[0], 0, p[1]]) rotate([90, 0, 0]) cylinder(d = mag_d + 3, h = cart_t, center = true);
                        if (groove_here) translate([key_gx - 4.5, s*cart_t/2 - (s > 0 ? cart_wall + 2.6 : 0), 0]) cube([9, cart_wall + 2.6, insert_depth + 3]);
                        // solid backing behind the card window
                        if (front) translate([-card[0]/2 - 3, -cart_t/2, card_z0 - 2]) cube([card[0] + 6, 3.4, body_top - card_z0 + 2]);
                    }
                    translate([-cart_w, -cart_t, -1]) cube([2*cart_w, 2*cart_t, body_top + 1]);
                }
                // solid tenon for the cap (also closes the top of the shell)
                translate([0, 0, body_top - 2]) intersection() {
                    translate([0, 0, -(body_top - 2)]) tenon_solid();
                    translate([-cart_w, -cart_t, 0]) cube([2*cart_w, 2*cart_t, cap_h - 1.6 + 2]);
                }
                // cap snap bumps on the tenon ends
                for (m = [-1, 1]) translate([m*(cart_w/2 - ten_end - 0.45), 0, body_top + 3.4]) rotate([90, 0, 0]) cylinder(r = 0.9, h = 6, center = true, $fn = 24);
            }
            translate([-cart_w, front ? -cart_t : 0, -1]) cube([2*cart_w, cart_t, cart_h + 2]);
        }
        for (p = mag_posts) translate([p[0], s*(mag_h/2 - eps), p[1]]) rotate([90, 0, 0]) cylinder(d = mag_d, h = mag_h, center = true);
        for (m = [-1, 1]) translate([m*(cart_w/2 + clear), 0, det_z]) rotate([90, 0, 0]) cylinder(r = bump_r + 0.2, h = cart_t + 2, center = true);
        for (m = [-1, 1], i = [0:3]) translate([m*cart_w/2, 0, insert_depth + 4 + i*3.5]) cube([1.6, cart_t + 2, 1.6], center = true);
        if (groove_here) translate([key_gx - rib_w/2 - 0.4, s > 0 ? cart_t/2 - rib_d - 0.6 : -cart_t/2 - 1, -1]) cube([rib_w + 0.8, rib_d + 0.6 + 1, insert_depth + 3]);
        if (tag_here) translate([0, s < 0 ? -(cart_t/2 - cart_wall) - 0.6 : cart_t/2 - cart_wall - 0.4, tag_z]) rotate([-90, 0, 0]) cylinder(d = tag_d + 0.6, h = 1);
        if (front) {
            // card channel (open at the top, closed by the cap) + window behind the lips
            translate([-card[0]/2 - 0.3, -cart_t/2 + lip_t, card_z0]) cube([card[0] + 0.6, card_t, cart_h]);
            translate([-win_x/2, -cart_t/2 - 1, card_z0 + 1.5]) cube([win_x, 1 + lip_t + eps, cart_h]);
            // fingernail notch to push the card up
            translate([0, -cart_t/2 - 1, card_z0 + 1.5]) rotate([-90, 0, 0]) cylinder(d = 10, h = 1 + lip_t + card_t);
        }
    }
}
module cart_cap() difference() {
    intersection() { cart_solid(); translate([-cart_w, -cart_t, body_top]) cube([2*cart_w, 2*cart_t, cap_h + 1]); }
    intersection() { tenon_solid(cap_fit); translate([-cart_w, -cart_t, body_top - 1]) cube([2*cart_w, 2*cart_t, cap_h - 1.6 + 1 + 0.2]); }
    for (m = [-1, 1]) translate([m*(cart_w/2 - ten_end - 0.45), 0, body_top + 3.4]) rotate([90, 0, 0]) cylinder(r = 1.05, h = cart_t - 2*ten + 1, center = true, $fn = 24);
    translate([-strip[0]/2 - 0.2, -cart_t/2 - 1, body_top + 2.6]) cube([strip[0] + 0.4, strip[2] + 1, strip[1] + 0.3]);   // strip groove
    translate([-name_rec[0]/2, -name_rec[1]/2, cart_h - name_rec[2]]) cube([name_rec[0], name_rec[1], 1]);             // name sticker
    translate([-card[0]/2 - 0.3, -cart_t/2 + lip_t, body_top - 1]) cube([card[0] + 0.6, card_t, 1.6]);              // card top edge tuck
}
module cart_strip() translate([-strip[0]/2, -cart_t/2 - 0.02, body_top + 2.75]) cube([strip[0], strip[2], strip[1]]);
module label_card() translate([-card[0]/2, -cart_t/2 + lip_t + 0.3, card_z0 + 0.2]) cube([card[0], 0.3, card[1] - 0.2]);
module cart_assembly() {
    color("#4a3020") { cart_half(true); cart_half(false); }
    translate([0, 0, explode_cap]) { color("#4d3222") cart_cap(); color("#3e6b4a") cart_strip(); }
    color([0.92, 0.88, 0.80]) label_card();
}

// ===================================================== stand-ins (fit) ==
module pi_standin() {
    z = base_t + standoff;
    translate([pi_x0, pi_y0, z]) cube([56, 85, 1.6]);                       // PCB
    translate([pi_x0 + 1, pi_y0 + 85 - 21, z + 1.6]) cube([54, 24, 16]);    // USB + Ethernet stack
    translate([pi_x0 + 3, pi_y0 + 85 + 3, z]) cube([49, 36, 16]);           // USB/Eth plugs + cable bend
    for (yy = [10.6, 32]) translate([pi_x0 + 56, pi_y0 + yy - 10, z]) cube([36, 20, 12]); // power + HDMI plugs
    translate([pi_x0, pi_y0 + 5, z + 1.6]) cube([7, 52, 26]);               // GPIO header + jumper wires
}
module reader_standin() translate([slot_x - pcb_w/2, slot_flip ? slot_y - sy - 0.05 - (pcb_t + 3) : slot_y + sy + 0.05, sleeve_top - sf_t - pcb_h]) cube([pcb_w, pcb_t + 3, pcb_h]);
module panel_standins() {
    cz = fp[1] + fp[3]/2;
    for (x = usb_x) translate([x - 8, 4.8, cz - 5]) cube([16, 22, 10]);       // USB panel mount bodies
    translate([btn_x, 4.8, cz]) rotate([-90, 0, 0]) cylinder(d = 15, h = 26); // button body
    cr = rp[1] + rp[3]/2;
    for (x = [rj_x, hdmi_x, pwr_x]) translate([x - 9, D - 4.8 - 24, cr - 7]) cube([18, 24, 14]);
}

// ============================================================ assembly ==
module place_bezel()  translate([slot_x, slot_y, bezel_z0]) rotate([0, 0, slot_flip ? 180 : 0]) children();
module place_sleeve() translate([slot_x, slot_y, sleeve_top]) rotate([0, 0, slot_flip ? 180 : 0]) children();
module place_lever()  if (eject_pressed)
        translate([0, pivot_y, pivot_z]) rotate([-atan(key_travel / (eject_y - pivot_y)), 0, 0])
            translate([0, -pivot_y, -pivot_z]) children();
    else children();

module assembly() {
    color([0.34, 0.21, 0.12]) body();
    color([0.42, 0.27, 0.16]) cap();
    color([0.90, 0.89, 0.86]) ring();
    color([0.36, 0.22, 0.13]) base();
    color([0.90, 0.89, 0.86]) place_bezel() bezel();
    color("#55555c") place_sleeve() sleeve();
    color([0.42, 0.27, 0.16]) place_lever() lever();
    color([0.90, 0.89, 0.86]) translate([slot_x, eject_y, arm_z + arm_t - (eject_pressed ? key_travel : 0)]) eject_key();
    color([0.90, 0.89, 0.86]) front_insert();
    color([0.90, 0.89, 0.86]) rear_insert();
    translate([slot_x, slot_y, cart_bottom]) cart_assembly();
}

if (part == "assembly") assembly();
if (part == "cap")    translate([0, 0, H]) rotate([180, 0, 0]) cap();
if (part == "body")   translate([0, 0, -base_t]) body();
if (part == "ring")   translate([0, 0, -zr]) ring();
if (part == "base")   base();
if (part == "faceplate") bezel();
if (part == "sleeve") rotate([180, 0, 0]) sleeve();
if (part == "lever")  translate([0, 0, -arm_z]) lever();
if (part == "key")    translate([0, 0, (H - 4.5) - (arm_z + arm_t) + 5]) rotate([180, 0, 0]) eject_key();
if (part == "front_plate") translate([0, 0, core + 2.4]) rotate([90, 0, 0]) translate([0, -core - 2.4, 0]) front_insert();
if (part == "rear_plate")  translate([0, 0, -(D - core - 2.4)]) rotate([90, 0, 0]) rear_insert();
if (part == "cart_front") translate([0, 0, cart_t/2]) rotate([90, 0, 0])  cart_half(true);
if (part == "cart_back")  translate([0, 0, cart_t/2]) rotate([-90, 0, 0]) cart_half(false);
if (part == "cart_cap")   translate([0, 0, cart_h]) rotate([180, 0, 0]) cart_cap();      // top face down
if (part == "cart_strip") rotate([90, 0, 0]) cart_strip();
if (part == "cart_assembly") cart_assembly();
if (part == "port_test")  port_test();
