DonohueRD/huey-console/(list of files, cad)

Other CAD files:
hardware/huey_walnut_v1/stl/lever.stl
hardware/huey_walnut_v1/stl/front_plate.stl
hardware/huey_station_v1/stl/cart_front.stl
hardware/huey_walnut_v1/stl/base.stl
hardware/huey_cart_v3/stl/cart_back.stl
hardware/huey_station_v1/stl/sleeve.stl
hardware/huey_walnut_v1/stl/cart_back.stl
hardware/huey_walnut_v1/stl/cart_front.stl
hardware/huey_station_v1/huey_station.scad
hardware/huey_walnut_v1/huey_walnut.scad
